MaximilianHq/Analog-Catfeeder/README.md

Final project in the course TNGE25 – Analog Electronics 2024 at Linköping University (LiU).
