MaximilianHq/Analog-Catfeeder/CatFeederModel.jpg

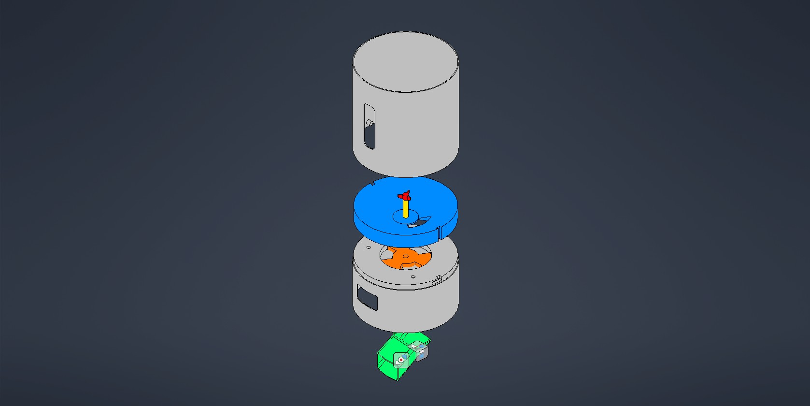
CatFeederModel.jpg
