MaximilianHq/Analog-Catfeeder/(list of files, cad)

Other CAD files:
Inventor - Kattmatare modell/CatFeeder.iam
Inventor - Kattmatare modell/base.ipt
Inventor - Kattmatare modell/baseAsm.ipt
Inventor - Kattmatare modell/cap.ipt
Inventor - Kattmatare modell/cover.ipt
Inventor - Kattmatare modell/feeder.ipt
Inventor - Kattmatare modell/rotor.ipt
Inventor - Kattmatare modell/shaft.ipt
Inventor - Kattmatare modell/tube.ipt
