MaximilianHq/Analog-Catfeeder/LTspice - Simuleringsfiler/555_Oscillator.asc

A1: or; Vhigh=5
A2: or; Vhigh=5
BAT: battery; 9
Controll: cap; 10n
Ct: cap; 100n
Q1: npn; 2N3904
R1: res; 4.7k
R2: res; 4.7k
R3: res; 4.7k
Ra: res; 8.2k
Rb: res; 8.2k
U1: opamp2; uA741
U2: opamp2; uA741
Named nets: 0, Threshold, R, S, Discharge, Trigger, ~Q, Output
.tran 0.51
.ic V(Trigger)=0
.include "uA741.sub"
