MaximilianHq/Analog-Catfeeder/LTspice - Simuleringsfiler/Stepper Motor Driver.asc

BAT: battery; 5
D1: diode; 1N4007
D2: diode; 1N4007
D3: diode; 1N4007
D4: diode; 1N4007
Q1: npn2; 2N2222
Q2: npn2; 2N2222
Q3: npn2; 2N2222
Q4: npn2; 2N2222
R1: res
R2: res
R3: res
R4: res
R5: res
R6: res
R7: res
R8: res
X1: StepperMotor
Named nets: 0, Q0, Q1, Q2, Q3
